thisranger/HanSolarButton/Poster.png

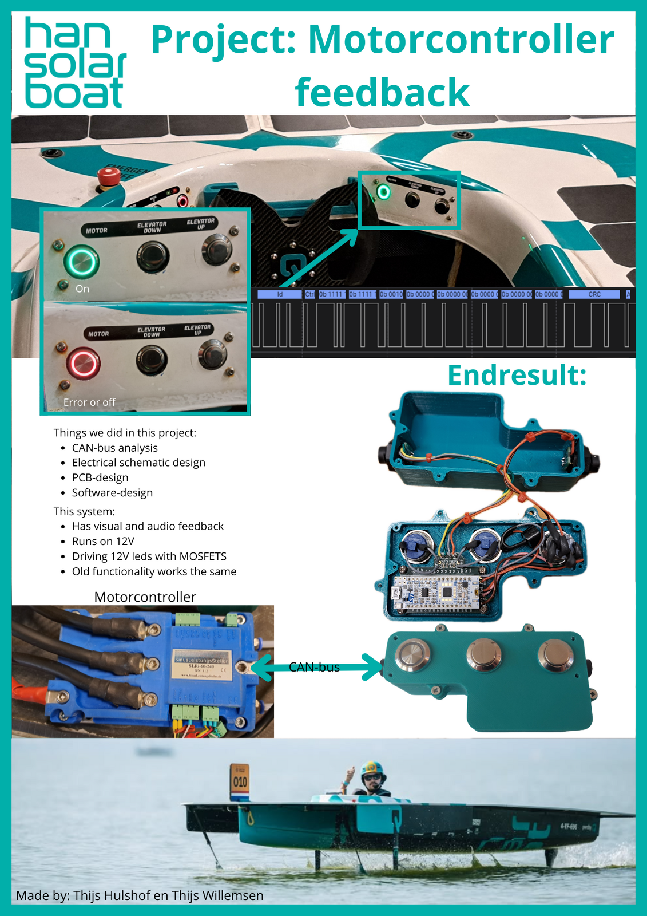
Poster.png
