thisranger/HanSolarButton/Documentatie/1.Realisatie/2.PCB/Backlog 2.0/2024_10_15 16_19 Office Lens.pdf

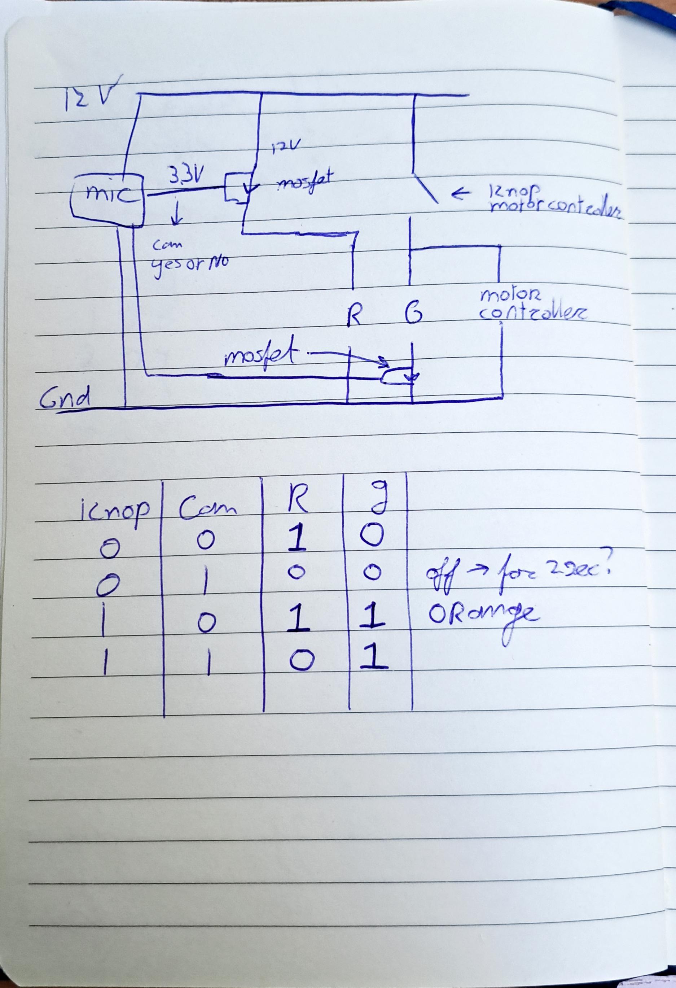
[picture p41: page 1]
