thisranger/HanSolarButton/Documentatie/1.Realisatie/2.PCB/Backlog 2.0/Layout_PCB.png

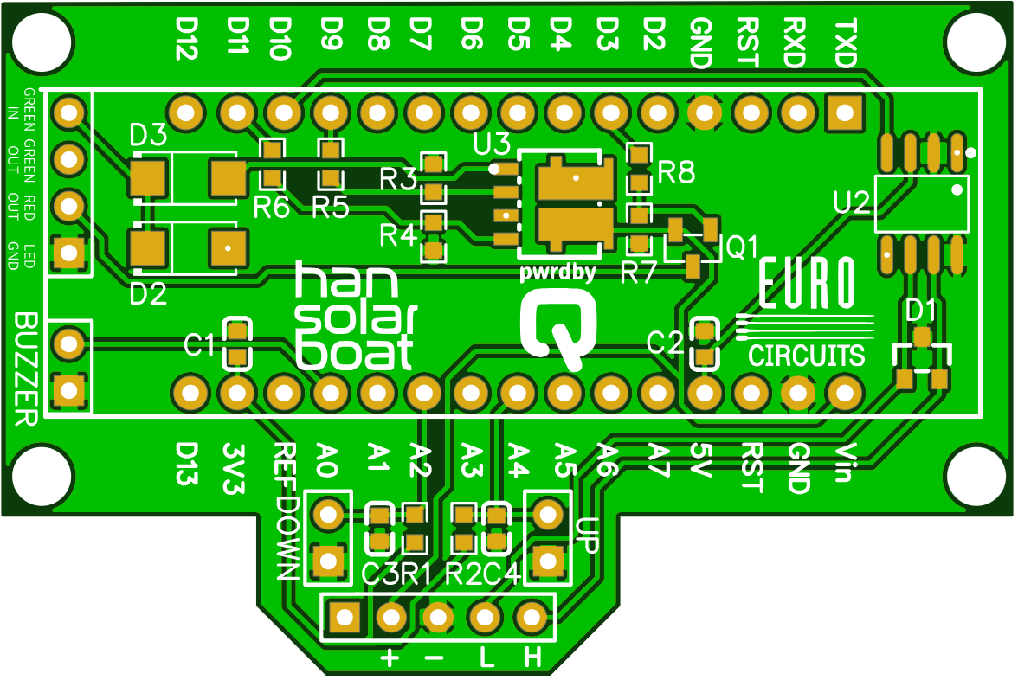
Documentatie/1.Realisatie/2.PCB/Backlog 2.0/Layout_PCB.png
