thisranger/HanSolarButton/Documentatie/1.Realisatie/3.Behuizing/ButtonBoxBottom_ThijsH.STL

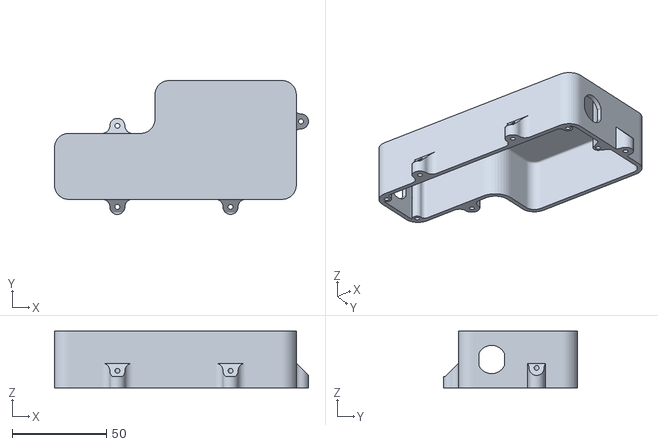
[picture p44: CAD file, 2025-03-12]
Documentatie/1.Realisatie/3.Behuizing/ButtonBoxBottom_ThijsH.STL
134.7 x 71.0 x 30.0
