thisranger/HanSolarButton/Documentatie/1.Realisatie/3.Behuizing/3_Button_box_large_V2.SLDPRT

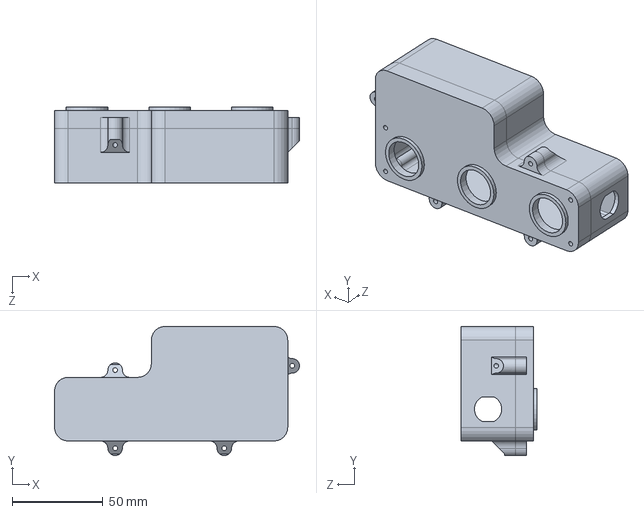
[picture p45: CAD file, 2025-03-12]
Documentatie/1.Realisatie/3.Behuizing/3_Button_box_large_V2.SLDPRT
134.7 x 71.0 x 42.0 mm
