thisranger/HanSolarButton/Documentatie/1.Realisatie/2.PCB/Schematic_SolarBoatButtonToCan_2024-11-13.pdf

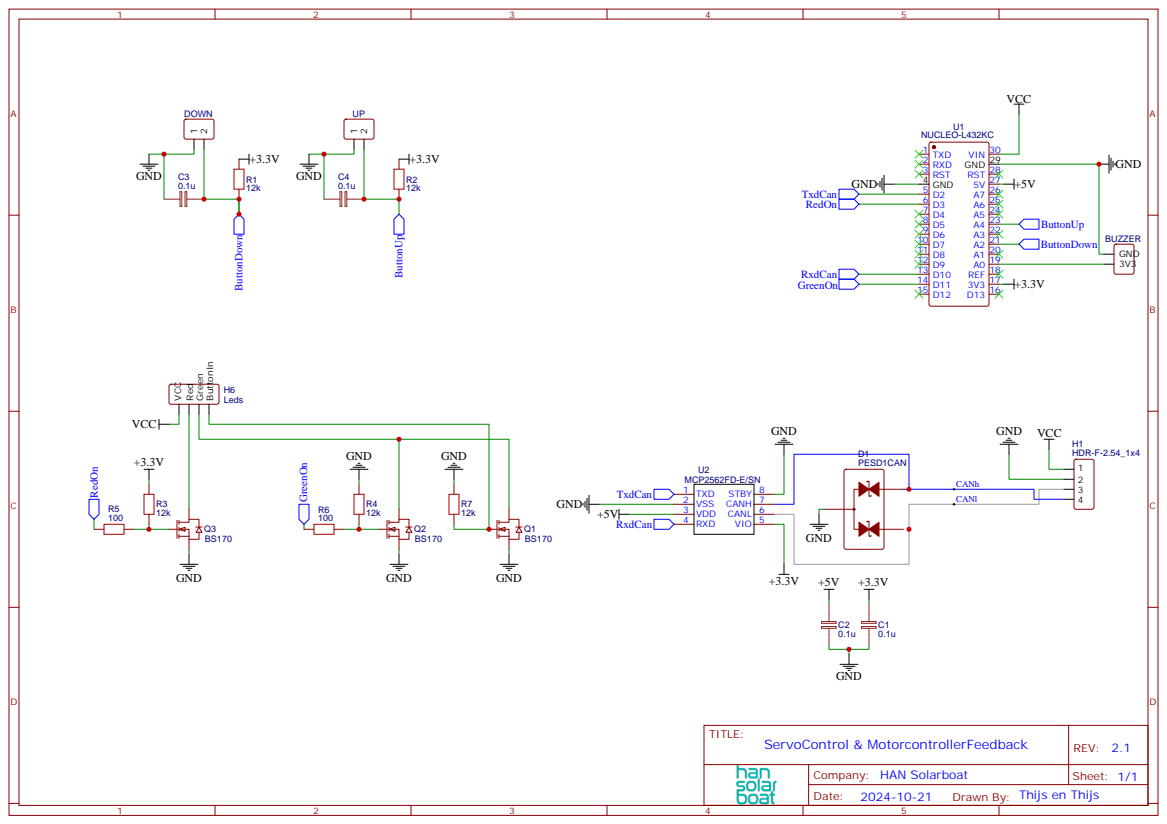
[picture p47: page 1]
