thisranger/HanSolarButton/Documentatie/1.Realisatie/2.PCB/Backlog 2.0/Schematic_SolarBoatButtonToCan_2024-10-22.pdf

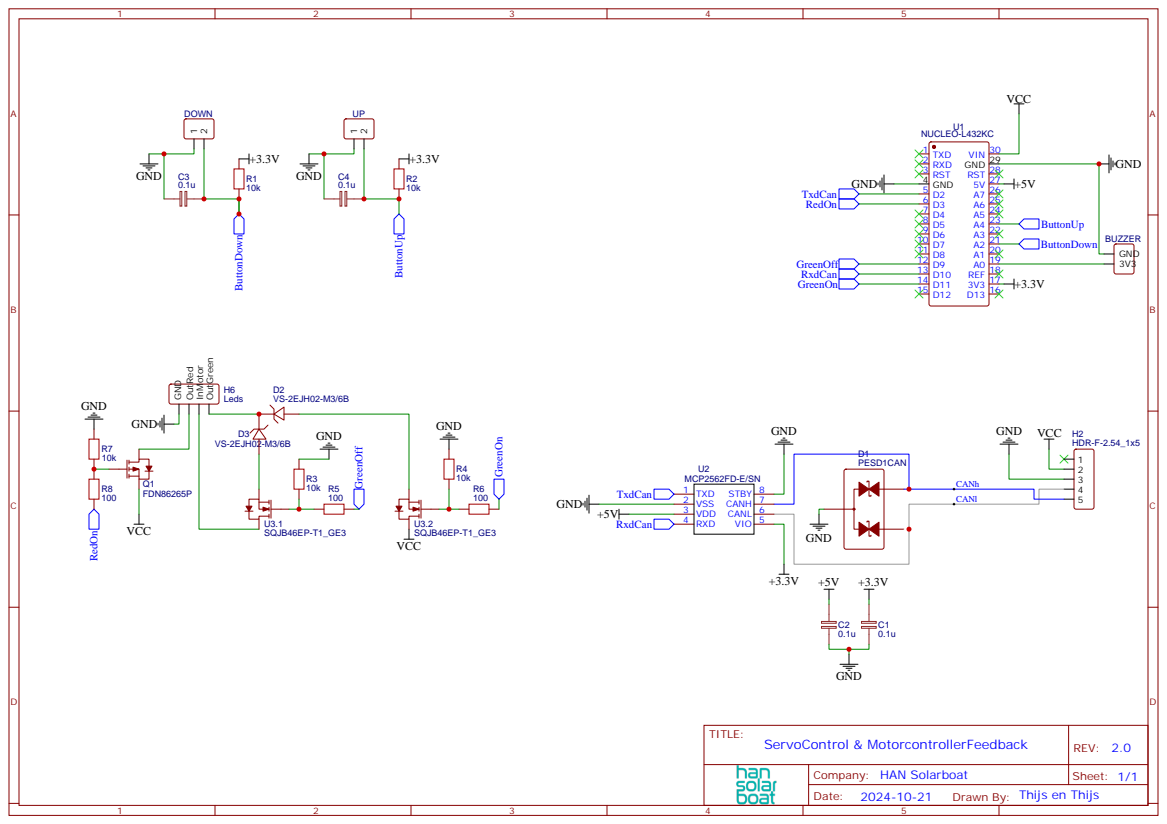
[picture p48: page 1]
