thisranger/HanSolarButton/Documentatie/1.Realisatie/1.Programma's/MainPrograms/SolarBoatServoControl/Core/Src/main.c

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
/* Includes ------------------------------------------------------------------*/
#include "main.h"
#include "can.h"
#include "tim.h"
#include "usart.h"
#include "gpio.h"


/* USER CODE BEGIN PV */
int32_t CH1_DC;

/* USER CODE END PV */

void SystemClock_Config(void);
/* USER CODE BEGIN 0 */

CAN_RxHeaderTypeDef   	RxHeader;
uint8_t               	RxData[8];
uint8_t 				datacheck;
uint16_t				angleFoil[14];




/* USER CODE END 0 */

/**
  * @brief  The application entry point.
  * @retval int
  */
int main(void)
{
  /* USER CODE BEGIN 1 */
 CH1_DC = 1450;

 // laagst is 1300
 // hoogst is 1850 8.3
 angleFoil[0] = 1300; //-1
 angleFoil[1] = 1325; //-0.5
 angleFoil[2] = 1350; //0
 angleFoil[3] = 1375; //0.5
 angleFoil[4] = 1420; //1
 angleFoil[5] = 1450; //1.5
 angleFoil[6] = 1475; //2
 angleFoil[7] = 1500; //2.5
 angleFoil[8] = 1550; //3
 angleFoil[9] = 1600; //3.5
 angleFoil[10] = 1650; //4
 angleFoil[11] = 1700; //4.5
 angleFoil[12] = 1750; //5

 //1750 7.6
 //1600
 //1550 3.5


  /* USER CODE END 1 */

  /* MCU Configuration--------------------------------------------------------*/

  /* Reset of all peripherals, Initializes the Flash interface and the Systick. */
  HAL_Init();

  /* Configure the system clock */
  SystemClock_Config();

  /* Initialize all configured peripherals */
  MX_GPIO_Init();
  MX_USART2_UART_Init();
  MX_CAN1_Init();
  MX_TIM1_Init();
  /* USER CODE BEGIN 2 */

  HAL_TIM_PWM_Start(&htim1, TIM_CHANNEL_1);

  /* USER CODE END 2 */

  /* Infinite loop */
  /* USER CODE BEGIN WHILE */
  while (1)
  {

		  TIM1->CCR1 = CH1_DC * 2;
    /* USER CODE END WHILE */

    /* USER CODE BEGIN 3 */
  }
  /* USER CODE END 3 */
}

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
/* USER CODE BEGIN 4 */

void HAL_CAN_RxFifo0MsgPendingCallback(CAN_HandleTypeDef *hcan)
{
  if (HAL_CAN_GetRxMessage(hcan, CAN_RX_FIFO0, &RxHeader, RxData) != HAL_OK)
  {
    Error_Handler();
  }

  if ((RxHeader.StdId == 0x360))
  {
	  CH1_DC = angleFoil[RxData[1]];
  }
}

/* USER CODE END 4 */
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
