thisranger/HanSolarButton/Documentatie/1.Realisatie/1.Programma's/MainPrograms/SolarBoatServoButtons/Core/Inc/main.h

#define Buzzer_Pin GPIO_PIN_0
#define Buzzer_GPIO_Port GPIOA
#define VCP_TX_Pin GPIO_PIN_2
#define VCP_TX_GPIO_Port GPIOA
#define ButtonDown_Pin GPIO_PIN_3
#define ButtonDown_GPIO_Port GPIOA
#define ButtonDown_EXTI_IRQn EXTI3_IRQn
#define ButtonUp_Pin GPIO_PIN_5
#define ButtonUp_GPIO_Port GPIOA
#define ButtonUp_EXTI_IRQn EXTI9_5_IRQn
#define RedLed_Pin GPIO_PIN_0
#define RedLed_GPIO_Port GPIOB
#define SWDIO_Pin GPIO_PIN_13
#define SWDIO_GPIO_Port GPIOA
#define SWCLK_Pin GPIO_PIN_14
#define SWCLK_GPIO_Port GPIOA
#define VCP_RX_Pin GPIO_PIN_15
#define VCP_RX_GPIO_Port GPIOA
#define LD3_Pin GPIO_PIN_3
#define LD3_GPIO_Port GPIOB
#define GreenLed_Pin GPIO_PIN_5
#define GreenLed_GPIO_Port GPIOB
