thisranger/HanSolarButton/(commit log)

2024-11-18 Working ServoButtons
2024-11-18 Added DemoPrograms
    [SolarBoatServoButtons Debug.cfg]
2024-11-19 Changed the frequency of the status transmission. Added a log for when the CAN-bus receive data
2024-11-25 Updated code with buzzer, millis and CAN-filter
    [can.c, main.c]
2024-12-11 Implemented driving green led
2024-12-16 Added an Error Handler
    [SolarBoatCockpitButtons.ioc, can.c, main.c]
2024-12-18 Made the error handler reboot
    [SolarBoatCockpitButtons.ioc, can.c, main.c]
2025-03-12 Added Handin
    [3_Button_box_large.SLDPRT, 3_Button_box_large_V2.SLDPRT, ButtonBoxBottom_ThijsH.STL, ButtonBoxTop_ThijsH.STL, SolarBoatServoButtons Debug.cfg]
