thisranger/HanSolarButton/(notices)

Notices in the files:
Documentatie/1.Realisatie/1.Programma's/MainPrograms/SolarBoatServoControl/Core/Src/main.c:
Copyright (c) 2023 STMicroelectronics.
All rights reserved.
This software is licensed under terms that can be found in the LICENSE file
